vuvvvv/Hyundai-smart-companion/tools/bitmaps_preview.png

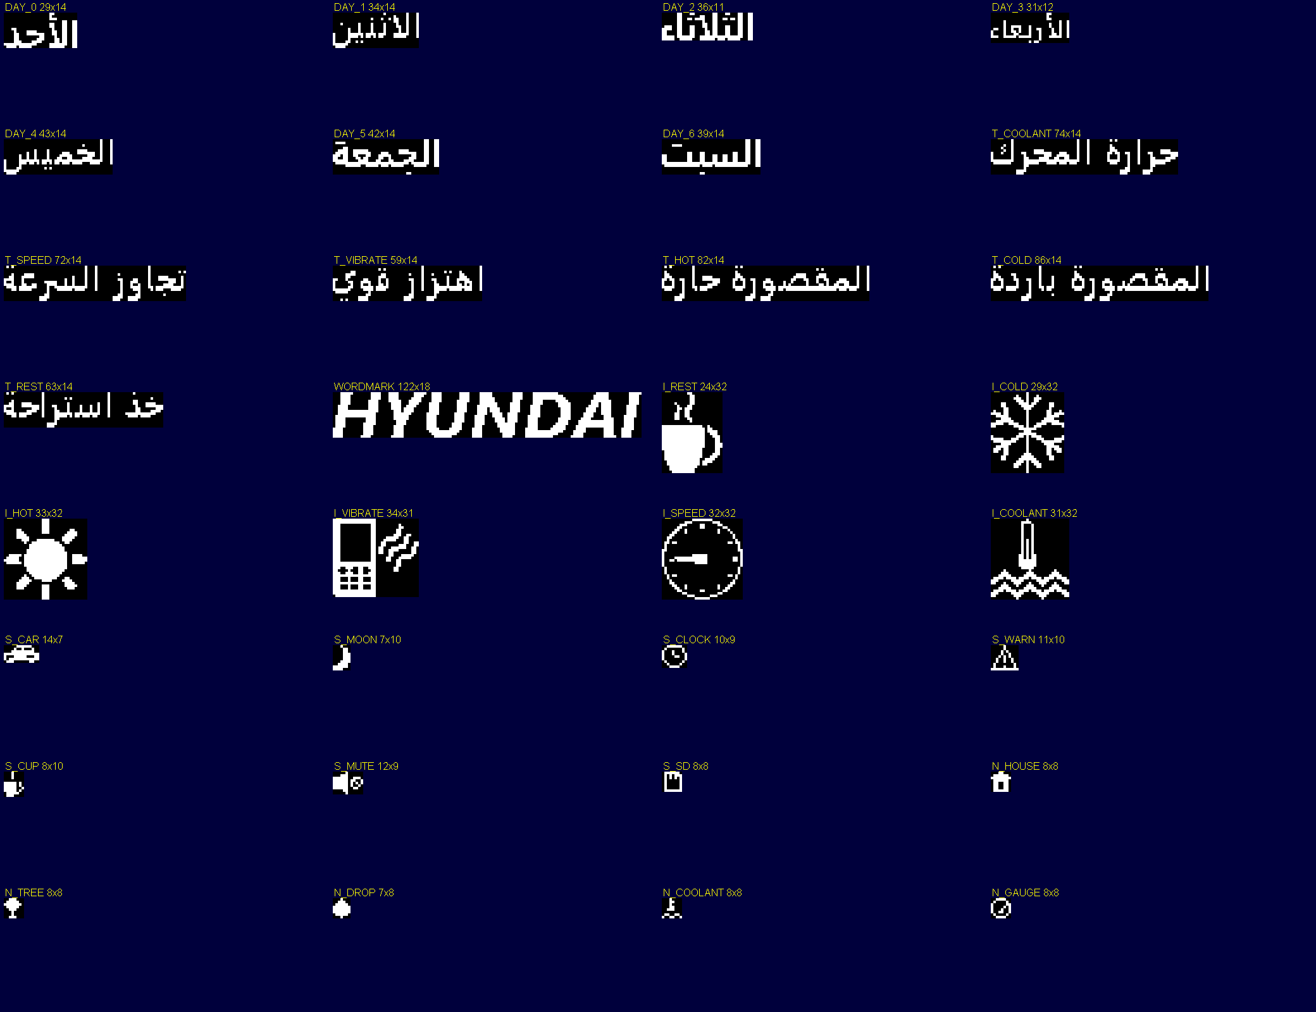
tools/bitmaps_preview.png
