vuvvvv/Hyundai-smart-companion/SD_card/جدول_الأصوات.csv

id | file | category | source
0001 | 0001.mp3 | تحية | صباح مساء/صباح الخير.mp3
0002 | 0002.mp3 | تحية | صباح مساء/مساء لخير.mp3
0003 | 0003.mp3 | تحية | كلمات مساعده/يا.mp3
0004 | 0004.mp3 | الاسم | اسمي/عبد العزيز.mp3
0005 | 0005.mp3 | صباحاً | صباح مساء/ص.mp3
0006 | 0006.mp3 | مساءً | صباح مساء/س.mp3
0010 | 0010.mp3 | تنبيه مستوى 3 | تنبيهات/تنبيه بسيط.mp3
0011 | 0011.mp3 | تنبيه مستوى 2 | تنبيهات/تنبيه متوسط.mp3
0012 | 0012.mp3 | تنبيه مستوى 1 | تنبيهات/تنبيه عالي الخطورة.mp3
0040 | 0040.mp3 | يوم الأسبوع | ايام الاسبوع/الاحد.mp3
0041 | 0041.mp3 | يوم الأسبوع | ايام الاسبوع/الاثنين.mp3
0042 | 0042.mp3 | يوم الأسبوع | ايام الاسبوع/الثلاثاء.mp3
0043 | 0043.mp3 | يوم الأسبوع | ايام الاسبوع/الاربعاء.mp3
0044 | 0044.mp3 | يوم الأسبوع | ايام الاسبوع/الخميس.mp3
0045 | 0045.mp3 | يوم الأسبوع | ايام الاسبوع/الجمعه.mp3
0046 | 0046.mp3 | يوم الأسبوع | ايام الاسبوع/السبت.mp3
0050 | 0050.mp3 | كلمة مساعدة | كلمات مساعده/الساعه الان.mp3
0051 | 0051.mp3 | كلمة مساعدة | كلمات مساعده/اليوم هو.mp3
0052 | 0052.mp3 | كلمة مساعدة | كلمات مساعده/تاريخ اليوم هو.mp3
0053 | 0053.mp3 | كلمة مساعدة | كلمات مساعده/من.mp3
0054 | 0054.mp3 | كلمة مساعدة | كلمات مساعده/و.mp3
0061 | 0061.mp3 | شهر | اسما الشهر/يناير.mp3
0062 | 0062.mp3 | شهر | اسما الشهر/فبراير.mp3
0063 | 0063.mp3 | شهر | اسما الشهر/مارس.mp3
0064 | 0064.mp3 | شهر | اسما الشهر/أبريل.mp3
0065 | 0065.mp3 | شهر | اسما الشهر/مايو.mp3
0066 | 0066.mp3 | شهر | اسما الشهر/يونيو.mp3
0067 | 0067.mp3 | شهر | اسما الشهر/يوليو.mp3
0068 | 0068.mp3 | شهر | اسما الشهر/أغسطس.mp3
0069 | 0069.mp3 | شهر | اسما الشهر/سبتمبر.mp3
0070 | 0070.mp3 | شهر | اسما الشهر/أكتوبر.mp3
0071 | 0071.mp3 | شهر | اسما الشهر/نوفمبر.mp3
0072 | 0072.mp3 | شهر | اسما الشهر/ديسمبر.mp3
0081 | 0081.mp3 | ساعة | الساعة/الساعة الواحدة.mp3
0082 | 0082.mp3 | ساعة | الساعة/الساعة الثانية.mp3
0083 | 0083.mp3 | ساعة | الساعة/3.mp3
0084 | 0084.mp3 | ساعة | الساعة/4.mp3
0085 | 0085.mp3 | ساعة | الساعة/5.mp3
0086 | 0086.mp3 | ساعة | الساعة/6.mp3
0087 | 0087.mp3 | ساعة | الساعة/7.mp3
0088 | 0088.mp3 | ساعة | الساعة/8.mp3
0089 | 0089.mp3 | ساعة | الساعة/9.mp3
0090 | 0090.mp3 | ساعة | الساعة/10.mp3
0091 | 0091.mp3 | ساعة | الساعة/11.mp3
0092 | 0092.mp3 | ساعة | الساعة/12.mp3
0101 | 0101.mp3 | دقيقة | دقيقه/دقيقة واحدة.mp3
0102 | 0102.mp3 | دقيقة | دقيقه/دقيقتان.mp3
0103 | 0103.mp3 | دقيقة | دقيقه/ثلاث دقائق.mp3
0104 | 0104.mp3 | دقيقة | دقيقه/4.mp3
0105 | 0105.mp3 | دقيقة | دقيقه/5.mp3
0106 | 0106.mp3 | دقيقة | دقيقه/6.mp3
0107 | 0107.mp3 | دقيقة | دقيقه/7.mp3
0108 | 0108.mp3 | دقيقة | دقيقه/8.mp3
0109 | 0109.mp3 | دقيقة | دقيقه/9.mp3
0110 | 0110.mp3 | دقيقة | دقيقه/10.mp3
0111 | 0111.mp3 | دقيقة | دقيقه/11.mp3
0112 | 0112.mp3 | دقيقة | دقيقه/12.mp3
0113 | 0113.mp3 | دقيقة | دقيقه/13.mp3
0114 | 0114.mp3 | دقيقة | دقيقه/14.mp3
0115 | 0115.mp3 | دقيقة | دقيقه/15.mp3
0116 | 0116.mp3 | دقيقة | دقيقه/16.mp3
0117 | 0117.mp3 | دقيقة | دقيقه/17.mp3
0118 | 0118.mp3 | دقيقة | دقيقه/18.mp3
0119 | 0119.mp3 | دقيقة | دقيقه/19.mp3
0120 | 0120.mp3 | دقيقة | دقيقه/20.mp3
0121 | 0121.mp3 | دقيقة | دقيقه/21.mp3
0122 | 0122.mp3 | دقيقة | دقيقه/22.mp3
0123 | 0123.mp3 | دقيقة | دقيقه/23.mp3
0124 | 0124.mp3 | دقيقة | دقيقه/24.mp3
0125 | 0125.mp3 | دقيقة | دقيقه/25.mp3
0126 | 0126.mp3 | دقيقة | دقيقه/26.mp3
0127 | 0127.mp3 | دقيقة | دقيقه/27.mp3
0128 | 0128.mp3 | دقيقة | دقيقه/28.mp3
0129 | 0129.mp3 | دقيقة | دقيقه/29.mp3
0130 | 0130.mp3 | دقيقة | دقيقه/30.mp3
0131 | 0131.mp3 | دقيقة | دقيقه/31.mp3
0132 | 0132.mp3 | دقيقة | دقيقه/32.mp3
0133 | 0133.mp3 | دقيقة | دقيقه/33.mp3
0134 | 0134.mp3 | دقيقة | دقيقه/34.mp3
0135 | 0135.mp3 | دقيقة | دقيقه/35.mp3
0136 | 0136.mp3 | دقيقة | دقيقه/36.mp3
0137 | 0137.mp3 | دقيقة | دقيقه/37.mp3
0138 | 0138.mp3 | دقيقة | دقيقه/38.mp3
0139 | 0139.mp3 | دقيقة | دقيقه/39.mp3
0140 | 0140.mp3 | دقيقة | دقيقه/40.mp3
0141 | 0141.mp3 | دقيقة | دقيقه/41.mp3
0142 | 0142.mp3 | دقيقة | دقيقه/42.mp3
0143 | 0143.mp3 | دقيقة | دقيقه/43.mp3
0144 | 0144.mp3 | دقيقة | دقيقه/44.mp3
0145 | 0145.mp3 | دقيقة | دقيقه/45.mp3
0146 | 0146.mp3 | دقيقة | دقيقه/46.mp3
0147 | 0147.mp3 | دقيقة | دقيقه/47.mp3
0148 | 0148.mp3 | دقيقة | دقيقه/48.mp3
0149 | 0149.mp3 | دقيقة | دقيقه/49.mp3
0150 | 0150.mp3 | دقيقة | دقيقه/50.mp3
0151 | 0151.mp3 | دقيقة | دقيقه/51.mp3
0152 | 0152.mp3 | دقيقة | دقيقه/52.mp3
0153 | 0153.mp3 | دقيقة | دقيقه/53.mp3
0154 | 0154.mp3 | دقيقة | دقيقه/54.mp3
0155 | 0155.mp3 | دقيقة | دقيقه/55.mp3
0156 | 0156.mp3 | دقيقة | دقيقه/56.mp3
0157 | 0157.mp3 | دقيقة | دقيقه/57.mp3
0158 | 0158.mp3 | دقيقة | دقيقه/58.mp3
0159 | 0159.mp3 | دقيقة | دقيقه/59.mp3
0226 | 0226.mp3 | سنة | سنوات/2026.mp3
0227 | 0227.mp3 | سنة | سنوات/2027.mp3
0228 | 0228.mp3 | سنة | سنوات/2028.mp3
0301 | 0301.mp3 | يوم الشهر | أيام الشهر/الأول.mp3
0302 | 0302.mp3 | يوم الشهر | أيام الشهر/الثاني.mp3
0303 | 0303.mp3 | يوم الشهر | أيام الشهر/الثالث.mp3
0304 | 0304.mp3 | يوم الشهر | أيام الشهر/الرابع.mp3
0305 | 0305.mp3 | يوم الشهر | أيام الشهر/الخامس.mp3
0306 | 0306.mp3 | يوم الشهر | أيام الشهر/السادس.mp3
0307 | 0307.mp3 | يوم الشهر | أيام الشهر/السابع.mp3
0308 | 0308.mp3 | يوم الشهر | أيام الشهر/الثامن.mp3
0309 | 0309.mp3 | يوم الشهر | أيام الشهر/التاسع.mp3
0310 | 0310.mp3 | يوم الشهر | أيام الشهر/العاشر.mp3
0311 | 0311.mp3 | يوم الشهر | أيام الشهر/الحادي عشر.mp3
0312 | 0312.mp3 | يوم الشهر | أيام الشهر/الثاني عشر.mp3
0313 | 0313.mp3 | يوم الشهر | أيام الشهر/الثالث عشر.mp3
0314 | 0314.mp3 | يوم الشهر | أيام الشهر/الرابع عشر.mp3
0315 | 0315.mp3 | يوم الشهر | أيام الشهر/الخامس عشر.mp3
0316 | 0316.mp3 | يوم الشهر | أيام الشهر/السادس عشر.mp3
0317 | 0317.mp3 | يوم الشهر | أيام الشهر/السابع عشر.mp3
0318 | 0318.mp3 | يوم الشهر | أيام الشهر/الثامن عشر.mp3
0319 | 0319.mp3 | يوم الشهر | أيام الشهر/التاسع عشر.mp3
0320 | 0320.mp3 | يوم الشهر | أيام الشهر/العشرون.mp3
0321 | 0321.mp3 | يوم الشهر | أيام الشهر/الحادي والعشرون.mp3
0322 | 0322.mp3 | يوم الشهر | أيام الشهر/الثاني والعشرون.mp3
0323 | 0323.mp3 | يوم الشهر | أيام الشهر/الثالث والعشرون.mp3
0324 | 0324.mp3 | يوم الشهر | أيام الشهر/الرابع والعشرون.mp3
0325 | 0325.mp3 | يوم الشهر | أيام الشهر/الخامس والعشرون.mp3
0326 | 0326.mp3 | يوم الشهر | أيام الشهر/السادس والعشرون.mp3
0327 | 0327.mp3 | يوم الشهر | أيام الشهر/السابع والعشرون.mp3
0328 | 0328.mp3 | يوم الشهر | أيام الشهر/الثامن والعشرون.mp3
0329 | 0329.mp3 | يوم الشهر | أيام الشهر/التاسع والعشرون.mp3
0330 | 0330.mp3 | يوم الشهر | أيام الشهر/الثلاثون.mp3
0331 | 0331.mp3 | يوم الشهر | أيام الشهر/الحادي والثلاثون.mp3
0401 | 0401.mp3 | جملة مدمجة | صباح الخير يا عبد العزيز (0001+0003+0004)
0402 | 0402.mp3 | جملة مدمجة | مساء الخير يا عبد العزيز (0002+0003+0004)
0601 | 0601.mp3 | جملة مدمجة | و + دقائق + صباحاً (0054+0101+0005)
0701 | 0701.mp3 | جملة مدمجة | و + دقائق + مساءً (0054+0101+0006)
0602 | 0602.mp3 | جملة مدمجة | و + دقائق + صباحاً (0054+0102+0005)
0702 | 0702.mp3 | جملة مدمجة | و + دقائق + مساءً (0054+0102+0006)
0603 | 0603.mp3 | جملة مدمجة | و + دقائق + صباحاً (0054+0103+0005)
0703 | 0703.mp3 | جملة مدمجة | و + دقائق + مساءً (0054+0103+0006)
0604 | 0604.mp3 | جملة مدمجة | و + دقائق + صباحاً (0054+0104+0005)
0704 | 0704.mp3 | جملة مدمجة | و + دقائق + مساءً (0054+0104+0006)
0605 | 0605.mp3 | جملة مدمجة | و + دقائق + صباحاً (0054+0105+0005)
0705 | 0705.mp3 | جملة مدمجة | و + دقائق + مساءً (0054+0105+0006)
0606 | 0606.mp3 | جملة مدمجة | و + دقائق + صباحاً (0054+0106+0005)
0706 | 0706.mp3 | جملة مدمجة | و + دقائق + مساءً (0054+0106+0006)
0607 | 0607.mp3 | جملة مدمجة | و + دقائق + صباحاً (0054+0107+0005)
0707 | 0707.mp3 | جملة مدمجة | و + دقائق + مساءً (0054+0107+0006)
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
0835 | 0835.mp3 | جملة مدمجة | من + الشهر + السنة (0053+0071+0228)
0836 | 0836.mp3 | جملة مدمجة | من + الشهر + السنة (0053+0072+0228)
0561 | 0561.mp3 | جملة مدمجة | من + الشهر (0053+0061)
0562 | 0562.mp3 | جملة مدمجة | من + الشهر (0053+0062)
0563 | 0563.mp3 | جملة مدمجة | من + الشهر (0053+0063)
0564 | 0564.mp3 | جملة مدمجة | من + الشهر (0053+0064)
0565 | 0565.mp3 | جملة مدمجة | من + الشهر (0053+0065)
0566 | 0566.mp3 | جملة مدمجة | من + الشهر (0053+0066)
0567 | 0567.mp3 | جملة مدمجة | من + الشهر (0053+0067)
0568 | 0568.mp3 | جملة مدمجة | من + الشهر (0053+0068)
0569 | 0569.mp3 | جملة مدمجة | من + الشهر (0053+0069)
0570 | 0570.mp3 | جملة مدمجة | من + الشهر (0053+0070)
0571 | 0571.mp3 | جملة مدمجة | من + الشهر (0053+0071)
0572 | 0572.mp3 | جملة مدمجة | من + الشهر (0053+0072)
