vuvvvv/Hyundai-smart-companion/3dfile/backcaver.stl

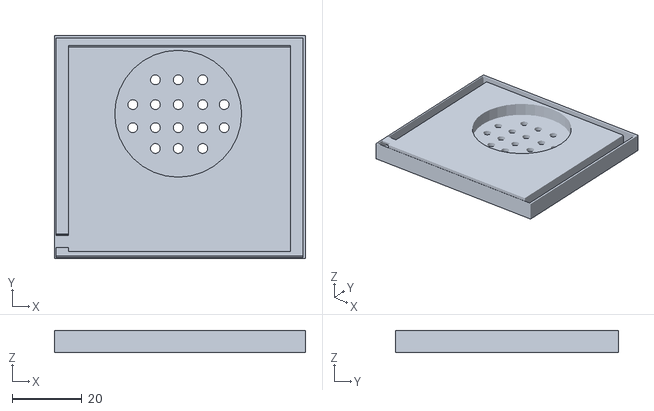
[picture p17: CAD file, 2026-10-30]
3dfile/backcaver.stl
72.0 x 64.0 x 6.40
