vuvvvv/Hyundai-smart-companion/3dfile/case.stl

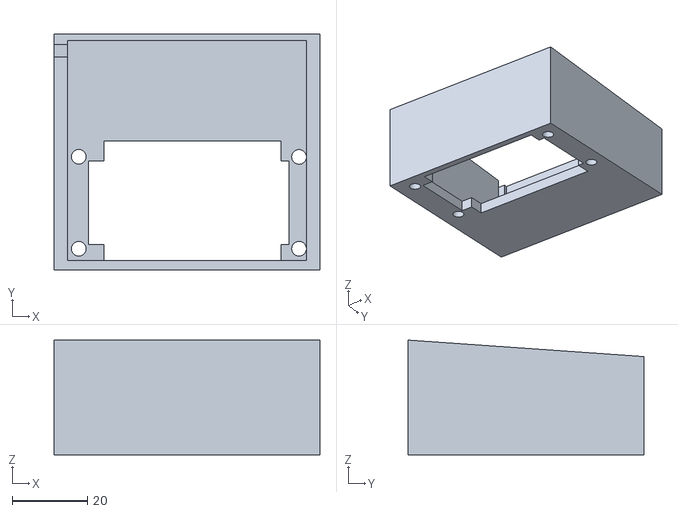
[picture p18: CAD file, 2026-10-30]
3dfile/case.stl
70.8 x 62.7 x 30.6
