vuvvvv/Hyundai-smart-companion/3dfile/frontcaver.stl

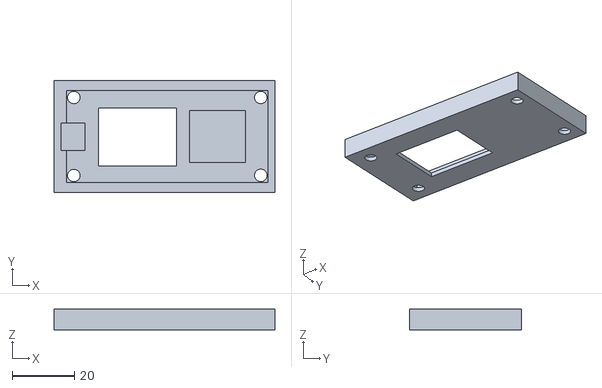
[picture p19: CAD file, 2026-10-30]
3dfile/frontcaver.stl
70.8 x 35.8 x 6.60
