vuvvvv/Hyundai-smart-companion/HyundaiCompanion/bitmaps.h

// ===== bitmaps.h — مُولّد تلقائياً بواسطة tools/gen_bitmaps.ps1، لا تعدله يدوياً =====
// النصوص العربية والرموز والشعار كصور نقطية 1-بت (صيغة Adafruit drawBitmap).
#pragma once
#include <stdint.h>

struct Bitmap { uint8_t w, h; const uint8_t* data; };

namespace bmp {
static const uint8_t DAY_0_DATA[] = {0x00,0x00,0x30,0x00,0x00,0x00,0x20,0x00,0x00,0x00,0x38,0x00,0x00,0x00,0x01,0x98,0x00,0x00,0x31,0x98,0x00,0x00,0x31,0x98,0x18,0x00,0x11,0x98,0x08,0x78,0x19,0x98,0x0C,0x7F,0x19,0x98,0x0C,0x03,0x09,0x98,0x0C,0x07,0x0D,0x98,0x0E,0x1E,0x0D,0x98,0xFF,0xF8,0x3F,0x98,0x7B,0xE0,0x3F,0x18};
constexpr Bitmap DAY_0 = {29, 14, DAY_0_DATA};
static const uint8_t DAY_1_DATA[] = {0x00,0x00,0x08,0x04,0x40,0x00,0x00,0x00,0x84,0x40,0x00,0x01,0x12,0xC4,0x40,0x00,0x00,0x00,0xC4,0x40,0x10,0x21,0x08,0x44,0x40,0x00,0x21,0x08,0x64,0x40,0x02,0x21,0x08,0x24,0x40,0x02,0x21,0x08,0x24,0x40,0x83,0xF7,0xB8,0xFC,0x40,0x83,0xD6,0xB0,0xF8,0x40,0x82,0x00,0x00,0x00,0x00,0x86,0x50,0x00,0x00,0x00,0xFC,0x00,0x00,0x00,0x00,0x78,0x00,0x00,0x00,0x00};
constexpr Bitmap DAY_1 = {34, 14, DAY_1_DATA};
static const uint8_t DAY_2_DATA[] = {0x03,0x18,0x0C,0x63,0x30,0x03,0x01,0x8C,0x03,0x30,0x03,0x37,0x8C,0xDB,0x30,0x03,0x00,0x8C,0x03,0x30,0x03,0x00,0xCC,0x03,0x30,0x73,0x18,0xCC,0x63,0x30,0xF3,0x18,0x4C,0x63,0x30,0xC3,0x18,0x6C,0x63,0x30,0xC3,0x18,0x6C,0x63,0x30,0xFB,0xF9,0xFF,0xFF,0x30,0xF9,0xF1,0xFB,0xBE,0x30};
constexpr Bitmap DAY_2 = {36, 11, DAY_2_DATA};
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
constexpr Bitmap N_COOLANT = {8, 8, N_COOLANT_DATA};
static const uint8_t N_GAUGE_DATA[] = {0x3C,0x42,0x83,0x85,0x89,0x99,0x42,0x3C};
constexpr Bitmap N_GAUGE = {8, 8, N_GAUGE_DATA};
constexpr Bitmap DAY[7] = {DAY_0, DAY_1, DAY_2, DAY_3, DAY_4, DAY_5, DAY_6};
}  // namespace bmp
